pongsatorntem/STM_AMR/STM_AMR_TRIGGER.xlsx

Sheet: Trigger_BNC
BENCHMARK : อุปกรณ์สั่งงาน (Trigger) — HzBoY F21-2S vs Telecrane F21-2S
หัวข้อเปรียบเทียบ | HzBoY F21-2S | Telecrane F21-2S | หมายเหตุ
ประเภท | Industrial RC — clone | Industrial RC — ของแท้ (ไต้หวัน)
ราคา/ชุด (THB) | 1600 | 2490
จำนวนปุ่ม | 2 ปุ่ม | 2 ปุ่ม
ความถี่วิทยุ | 433 MHz | 433 MHz
ระยะสัญญาณ (โล่ง) | 100–300 ม. | ~100 ม.
มาตรฐาน IP | IP67 | IP65 (certified)
ขนาด TX (มม.) | 70 × 48 × 110 | 130 × 45 × 22
น้ำหนัก TX | ไม่ระบุ | ~120 กรัม
ไฟเลี้ยง TX | AA 2 ก้อน | AA 2 ก้อน
ถ่านอยู่ได้ | ไม่ระบุ | ~4 เดือน
ไฟเลี้ยง RX | DC 12–24V | DC 12–24V
Output RX | Dry contact relay | Dry contact relay
Action กับคนขับ | ไฟเขียวที่ TX แว็บเดียว | ไฟเขียวที่ TX แว็บเดียว
เขียนโค้ดเพิ่ม | ไม่ต้อง | ไม่ต้อง
รหัสสัญญาณ | ไม่ชัดเจน เสี่ยงชนถ้าหลายชุด | 4.3 พันล้านรหัส
มีซอฟต์แวร์ตั้งค่า | ไม่มี | มี

Sheet: Trigger_BOM
BOM : อุปกรณ์ Trigger — เปรียบเทียบรายการวัสดุ
── Option A : HzBoY F21-2S ──
No | รายการ | Part No. / รุ่น | ผู้ผลิต/แหล่งซื้อ | จำนวน | หน่วย | ราคาต่อหน่วย (THB) | ราคารวม (THB) | หมายเหตุ
1 | รีโมทคอนโทรลไร้สาย | F21-2S DC12-24V |  | 1 | ชุด | 1600 | 1600
2 | ถ่าน AA (สำรอง) | ถ่านอัลคาไลน์ AA |  | 4 | ก้อน | 15 | 60
3 | สายไฟ 0.5mm² ยาว 1m | สาย THW 0.5mm² |  | 2 | เส้น | 20 | 40
4 | Connector 2 pin | JST 2P หรือ Dupont |  | 2 | ชุด | 5 | 10
 |  |  |  |  |  | รวม Option A | 1710
── Option B : Telecrane F21-2S ──
No | รายการ | Part No. / รุ่น | ผู้ผลิต/แหล่งซื้อ | จำนวน | หน่วย | ราคาต่อหน่วย (THB) | ราคารวม (THB) | หมายเหตุ
1 | รีโมทคอนโทรลไร้สาย Telecrane | F21-2S/D 12-24VDC |  | 1 | ชุด | 2490 | 2490
2 | ถ่าน AA (สำรอง) | ถ่านอัลคาไลน์ AA |  | 4 | ก้อน | 15 | 60
3 | สายไฟ 0.5mm² ยาว 1m | สาย THW 0.5mm² |  | 2 | เส้น | 20 | 40
4 | Connector 2 pin | JST 2P หรือ Dupont |  | 2 | ชุด | 5 | 10
 |  |  |  |  |  | รวม Option B | 2600

Sheet: HMI_BNC
BENCHMARK : อุปกรณ์เสียงเตือน (HMI) — เทียบ 4 ตัวเลือก
หัวข้อเปรียบเทียบ | Piezo Buzzer (ทั่วไป) | Schneider XB5KS2B4 | Patlite BSV-24N | Qlight S60ADH | หมายเหตุ
ประเภท | Piezo buzzer | Buzzer+Beacon combo | MP3 Voice Annunciator | Wall-mount buzzer horn
ราคา (THB) | 60–300 | 1100 | ~5,000 | ~660
ระดับเสียง | 85–95 dB @1m | 90 dB @1m | 87 dB @1m | 95 dB @1m
ความถี่เสียง | 2–4 kHz (สูง) | 4 kHz + 6.8 kHz (สูง) | 1 kHz sine (กลาง-ต่ำ) | หลายความถี่
ได้ยินจริงในพื้นที่ | 3–5 ม. | 3–5 ม. (ความถี่สูงเกิน) | 10–20 ม. | 10–15 ม.
IP rating | IP54 | IP66 / IP67 / IP69K | IP54 | IP54
ไฟเลี้ยง | DC 6–24V | DC/AC 24V | DC 12–24V | DC 24V / AC 220V
กินไฟ | <1W | ~2W | 3.5W (max) | ~5W
ขนาด (มม.) | Ø30–50 × 30 | ≈ Ø40 × 70 | 75 × 75 × 19.9 | ไม่ระบุในหน้าเว็บ
เสียงหลายแบบ/สถานะ | ไม่มี (เสียงเดียว) | 2 โทน (buzzer+beacon) | 15 เสียง + MP3 custom | ไม่มี (เสียงเดียว)
ต่อ Arduino Mega | DO → transistor/relay | DO → relay | DO 4 ช่อง NPN โดยตรง | DO → relay
มาตรฐาน/เอกสาร | ไม่มี | CE, IP66/67/69, IK08 | CE, IP54, RoHS | CE, IP54, RoHS
หาซื้อในไทย | ทั่วไป (Shopee/ร้านITEM) | ตัวแทน | ตัวแทน | qlightthailand.com
เหมาะ scope นี้ | POC เท่านั้น | รอยืนยัน dB จริง | แนะนำ (ยืดหยุ่นสูงสุด) | ราคาต่ำ ใช้งานง่าย

Sheet: HMI_BOM
BOM : อุปกรณ์เสียงเตือน (HMI) — รายการวัสดุ 4 ตัวเลือก
── Option A : Piezo Buzzer — POC ──
No | รายการ | Part No. / รุ่น | แหล่งซื้อในไทย | จำนวน | หน่วย | ราคาต่อหน่วย (THB) | ราคารวม (THB) | หมายเหตุ
1 | Piezo buzzer 12V IP54 | KPI-G2312L หรือเทียบเท่า | Shopee / ร้านอิเล็กทรอนิกส์ | 1 | ชุด | 150 | 150 | 85-90 dB ความถี่ 2-4 kHz
2 | สายไฟ 0.5mm² ยาว 0.5m | THW 0.5mm² | ร้านไฟฟ้า | 1 | เส้น | 10 | 10 | ต่อ DO Arduino → buzzer
3 | Resistor 1kΩ (กัน DO Arduino) | 1kΩ 1/4W | ร้านอิเล็กทรอนิกส์ | 1 | ตัว | 1 | 1 | กัน DO Arduino
 |  |  |  |  |  | รวม | 161
── Option B : Schneider XB5KS2B4 — รอยืนยัน dB จริง ──
No | รายการ | Part No. / รุ่น | แหล่งซื้อในไทย | จำนวน | หน่วย | ราคาต่อหน่วย (THB) | ราคารวม (THB) | หมายเหตุ
1 | Buzzer+Beacon combo | XB5KS2B4 | RS Components TH / ตัวแทน Schneider | 1 | ชุด | 1500 | 1500 | IP66/67/69 24V 90dB เคลม — รอยืนยันจากร้าน
2 | สายไฟ 0.5mm² ยาว 0.5m | THW 0.5mm² | ร้านไฟฟ้า | 1 | เส้น | 10 | 10
3 | Relay module 24V | HF3FF-024-1ZS หรือเทียบเท่า | Shopee | 1 | ตัว | 60 | 60 | ถ้า DO Arduino ไม่พอขับ
 |  |  |  |  |  | รวม | 1570
── Option C : Patlite BSV-24N — แนะนำ Production ──
No | รายการ | Part No. / รุ่น | แหล่งซื้อในไทย | จำนวน | หน่วย | ราคาต่อหน่วย (THB) | ราคารวม (THB) | หมายเหตุ
1 | MP3 Voice Annunciator | BSV-24N-W | MISUMI TH / monet.asia | 1 | ชุด | 5028 | 5028 | 87dB 12-24VDC NPN input 4CH IP54
2 | MicroSD card | MicroSD 1-4GB FAT32 | ร้านทั่วไป | 1 | ชิ้น | 80 | 80 | อัดเสียง MP3 chime/Thai voice
3 | สายไฟ 0.5mm² ยาว 0.5m | THW 0.5mm² | ร้านไฟฟ้า | 2 | เส้น | 10 | 20 | ไฟเลี้ยง + DO จาก Arduino
4 | Connector 4 pin (DO) | Molex/JST 4P | ร้านอิเล็กทรอนิกส์ | 1 | ชุด | 15 | 15 | ต่อ CH1-CH4
 |  |  |  |  |  | รวม | 5143
── Option D : Qlight S60ADH — Pilot ประหยัด ──
No | รายการ | Part No. / รุ่น | แหล่งซื้อในไทย | จำนวน | หน่วย | ราคาต่อหน่วย (THB) | ราคารวม (THB) | หมายเหตุ
1 | Wall-mount buzzer horn | S60ADH-24 | qlightthailand.com | 1 | ชุด | 660 | 660 | 95dB 24VDC IP54
2 | Relay module 24V | HF3FF-024-1ZS หรือเทียบเท่า | Shopee | 1 | ตัว | 60 | 60 | DO Arduino → relay → buzzer
3 | สายไฟ 0.5mm² ยาว 0.5m | THW 0.5mm² | ร้านไฟฟ้า | 1 | เส้น | 10 | 10
 |  |  |  |  |  | รวม | 730
