pongsatorntem/STM_AMR/(commit log)

2026-08-18 Add minimal BOM workbook
    [BOM_STM_AMR.xlsx]
2026-08-26 Update BOM with pricing and links
    [BOM_STM_AMR.xlsx]
2026-08-26 Add trigger wiring diagrams
    [STM_AMR_TRIGGER.xlsx]
